Sidsolegend/lyra-imu-gesture/case/renders/functional.png

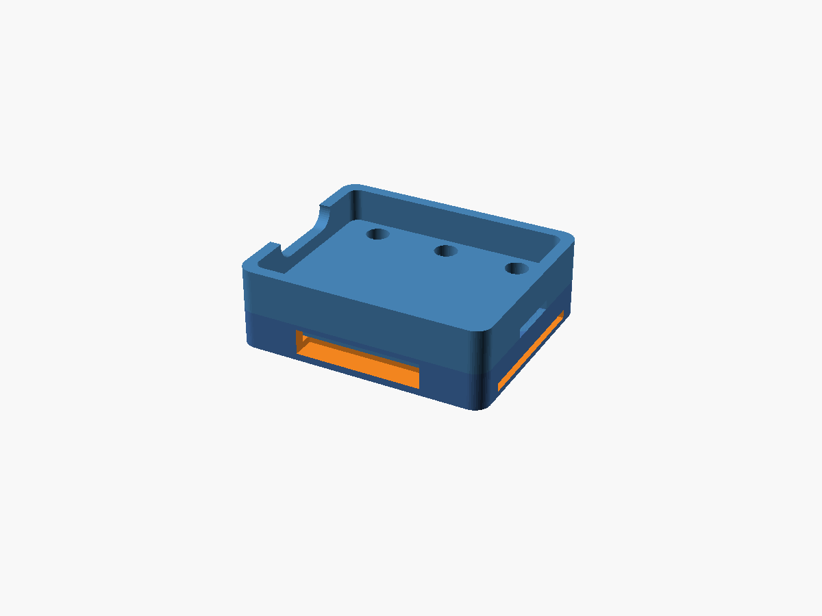
case/renders/functional.png
