Sidsolegend/lyra-imu-gesture/case/renders_v2/v2_batt_on.png

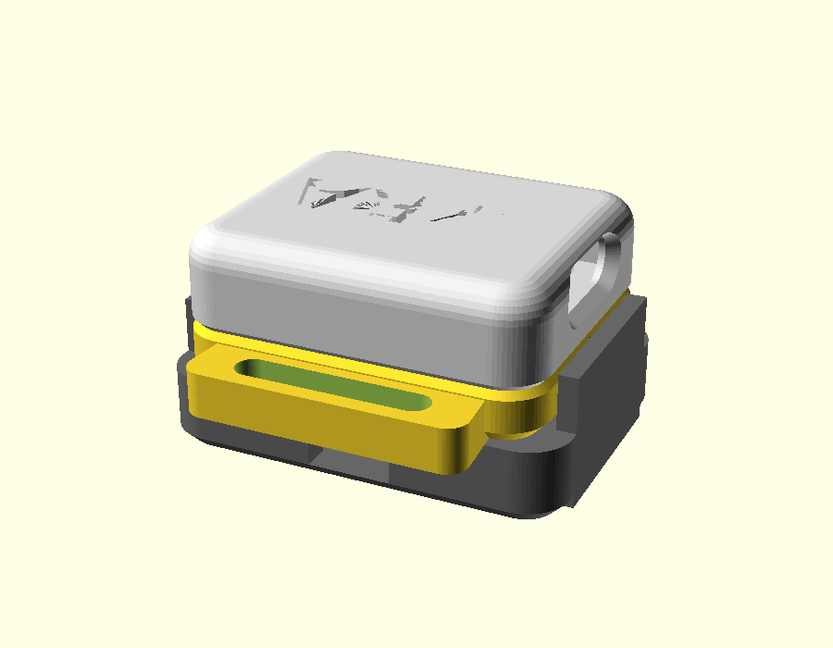
case/renders_v2/v2_batt_on.png
