Sidsolegend/lyra-imu-gesture/case/renders_v2/v2_plate.png

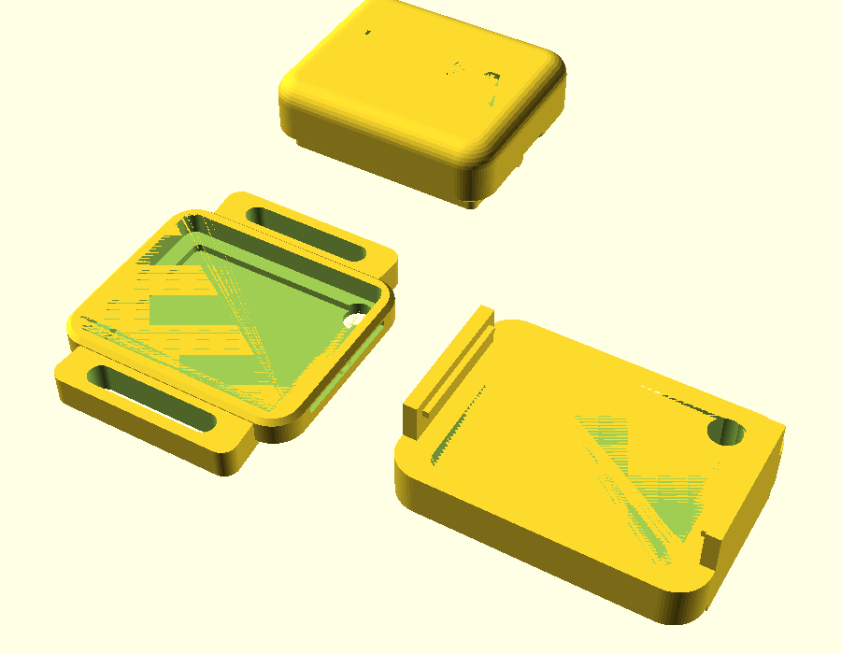
case/renders_v2/v2_plate.png
