Sidsolegend/lyra-imu-gesture/figures/mechanism_critical_gain.png

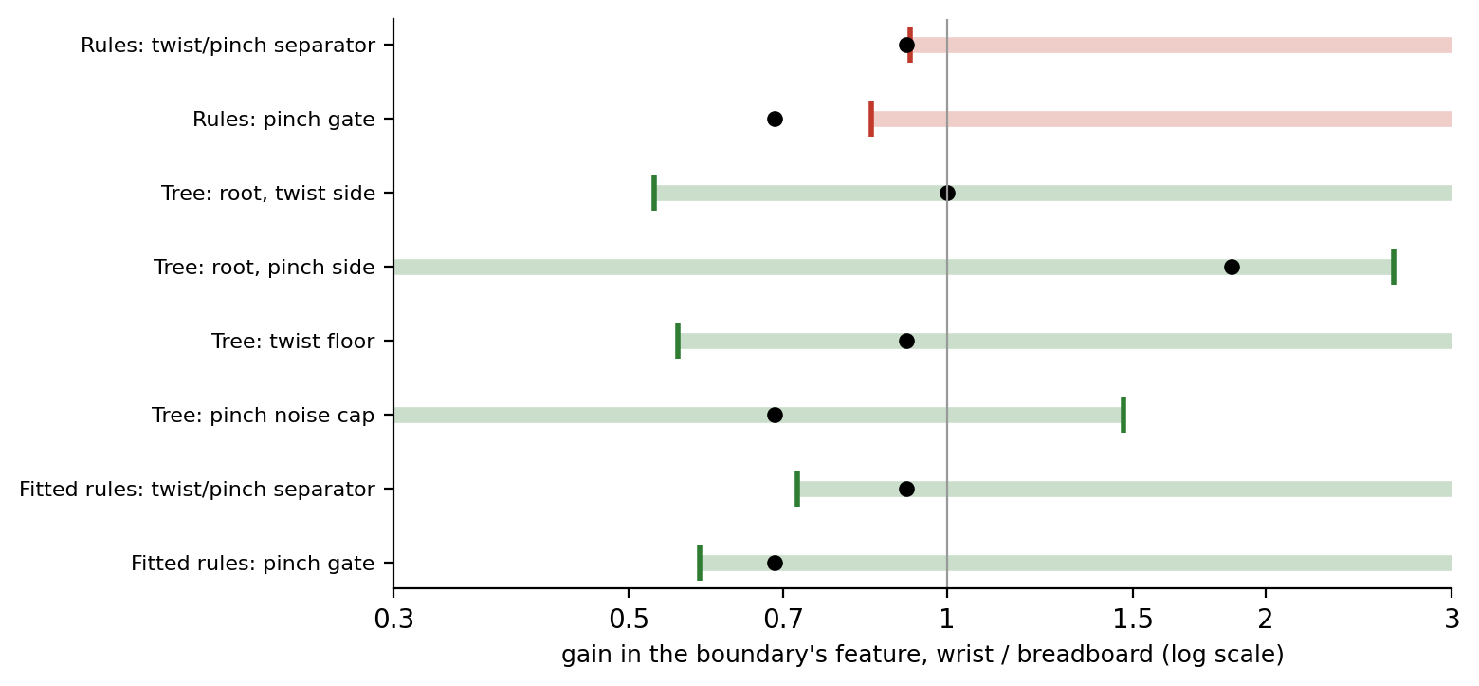
figures/mechanism_critical_gain.png
