Sidsolegend/lyra-imu-gesture/figures/mechanism_gain_sweep.png

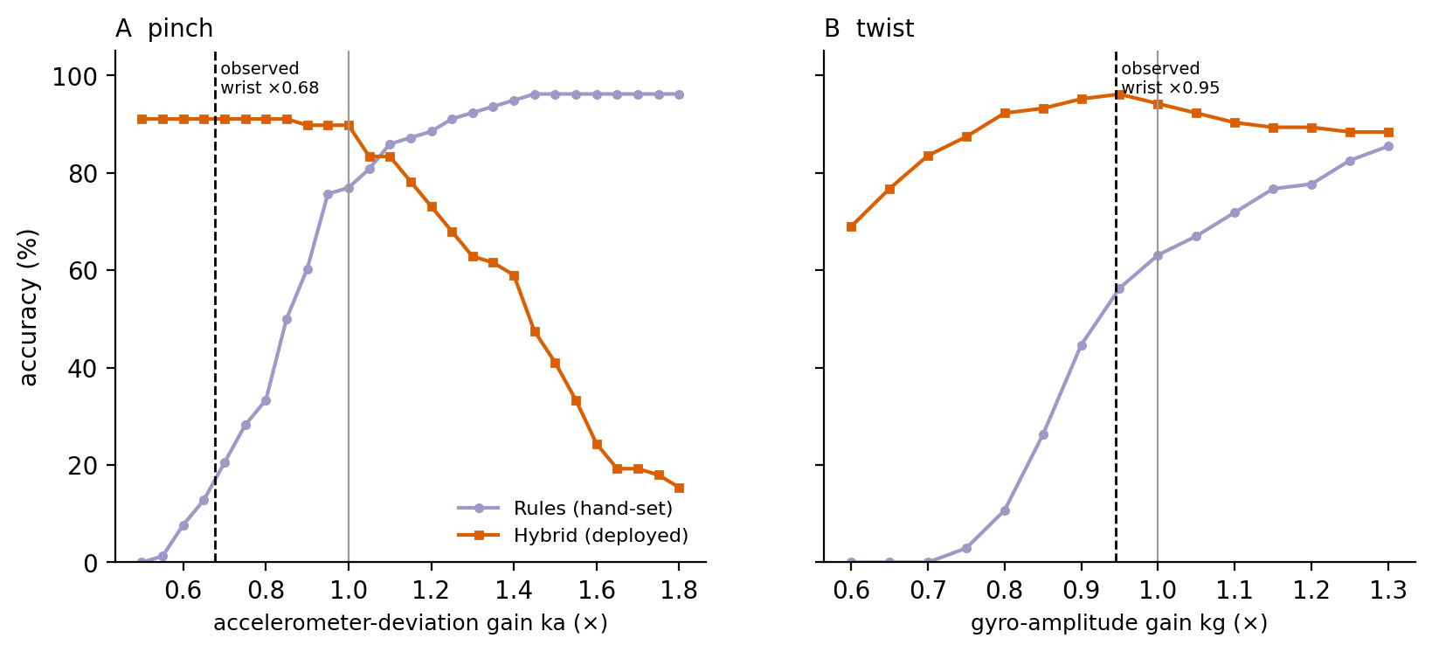
figures/mechanism_gain_sweep.png
