Sidsolegend/lyra-imu-gesture/case/stl/lyra_plate.stl

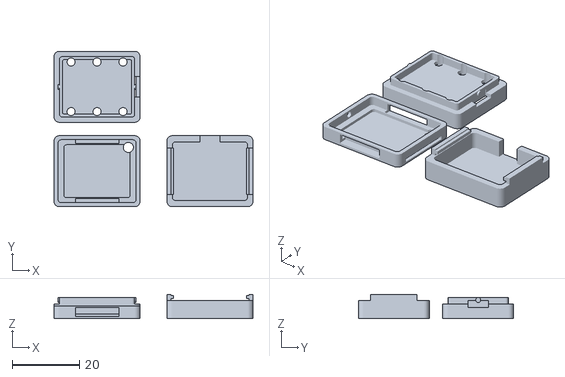
[picture p15: CAD file, 2026-10-30]
case/stl/lyra_plate.stl
59.4 x 46.4 x 7.30
