Sidsolegend/lyra-imu-gesture/case/stl_v2/lyra_v2_base.stl

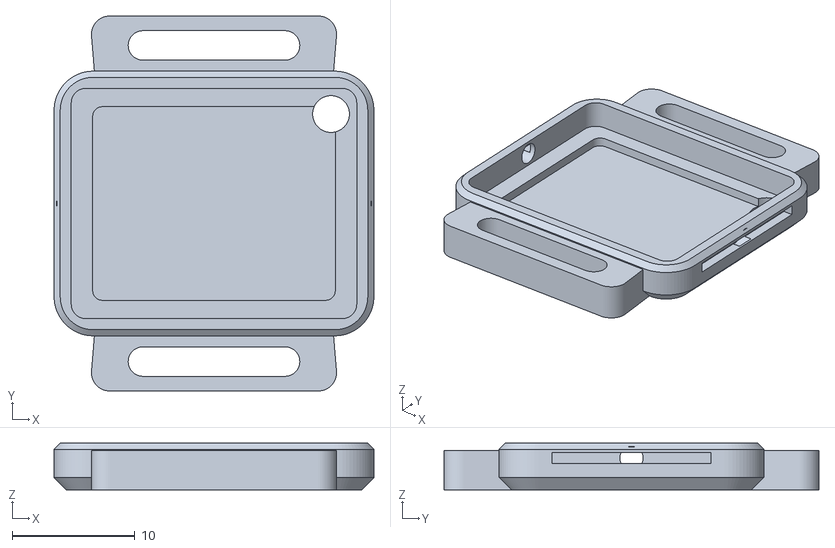
[picture p16: CAD file, 2026-10-30]
case/stl_v2/lyra_v2_base.stl
26.1 x 30.6 x 3.81
