Sidsolegend/lyra-imu-gesture/case/stl/lyra_pro_plate.stl

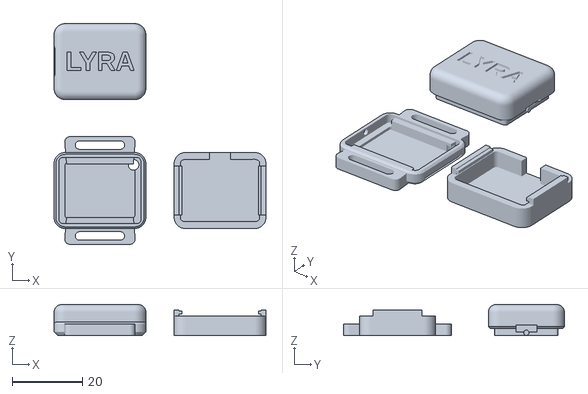
[picture p17: CAD file, 2026-10-30]
case/stl/lyra_pro_plate.stl
60.2 x 62.7 x 8.81
