Sidsolegend/lyra-imu-gesture/case/stl_v2/lyra_v2_plate.stl

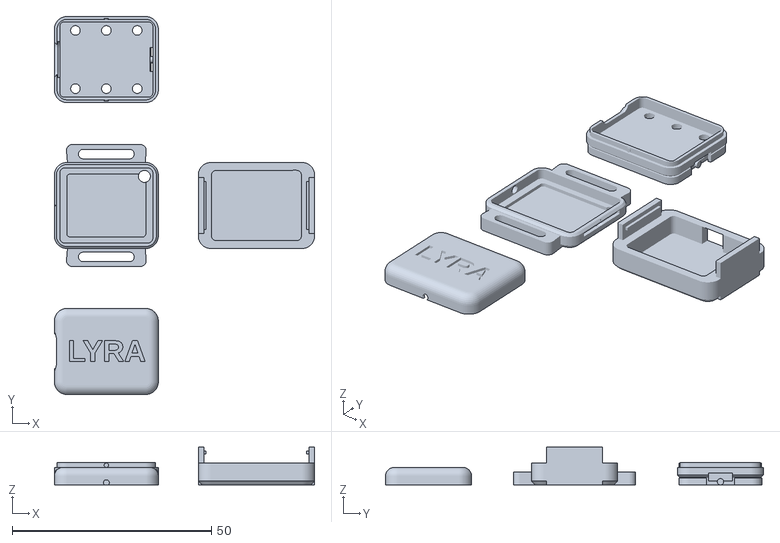
[picture p18: CAD file, 2026-10-30]
case/stl_v2/lyra_v2_plate.stl
65.3 x 94.8 x 9.50
