Sidsolegend/lyra-imu-gesture/case/stl/lyra_top.stl

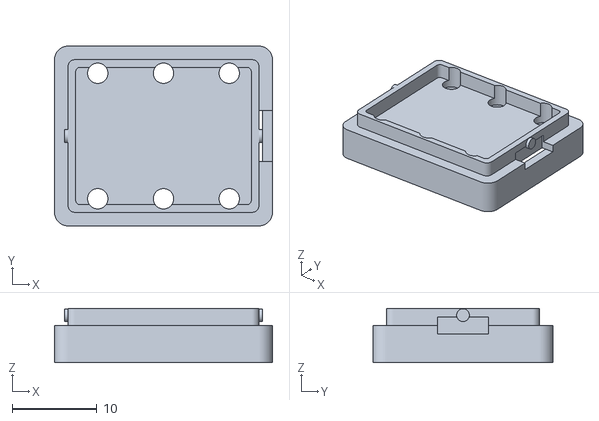
[picture p19: CAD file, 2026-10-30]
case/stl/lyra_top.stl
25.7 x 21.2 x 6.40
