Sidsolegend/lyra-imu-gesture/case/stl_v2/lyra_v2_top.stl

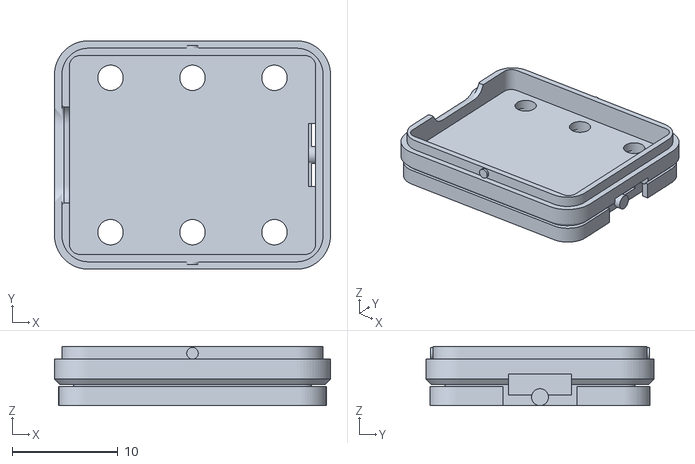
[picture p20: CAD file, 2026-10-30]
case/stl_v2/lyra_v2_top.stl
26.1 x 21.6 x 5.60
