Sidsolegend/lyra-imu-gesture/case/stl/lyra_pro_battery.stl

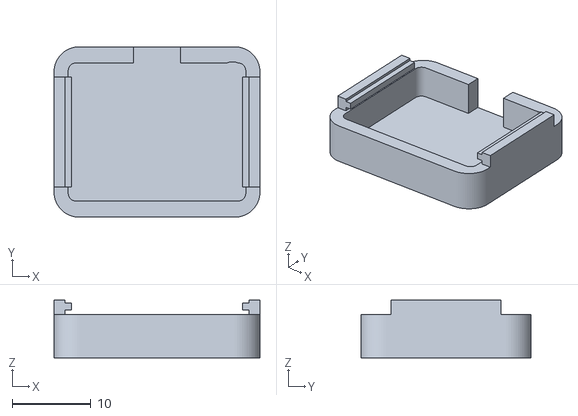
[picture p21: CAD file, 2026-10-30]
case/stl/lyra_pro_battery.stl
26.1 x 21.6 x 7.30
