Sidsolegend/lyra-imu-gesture/case/stl_v2/lyra_v2_battery.stl

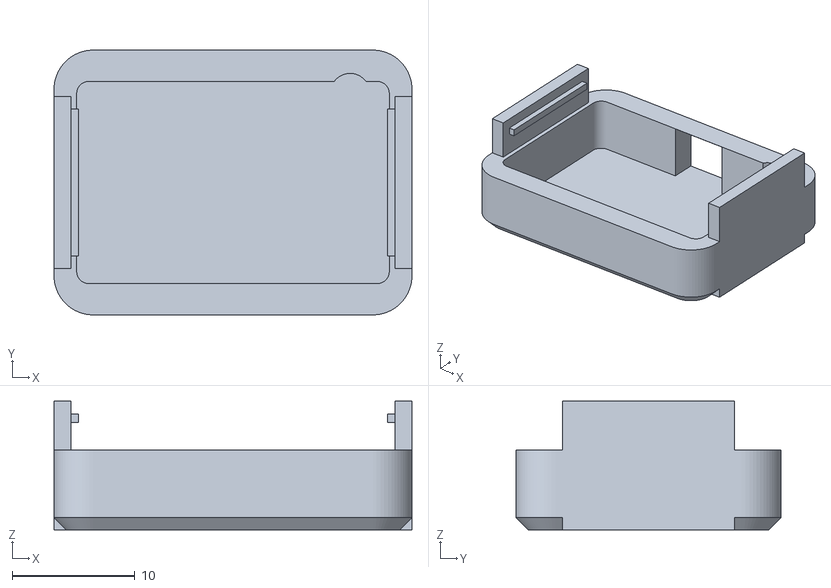
[picture p22: CAD file, 2026-10-30]
case/stl_v2/lyra_v2_battery.stl
29.2 x 21.6 x 10.5
