Sidsolegend/lyra-imu-gesture/case/stl/lyra_battery.stl

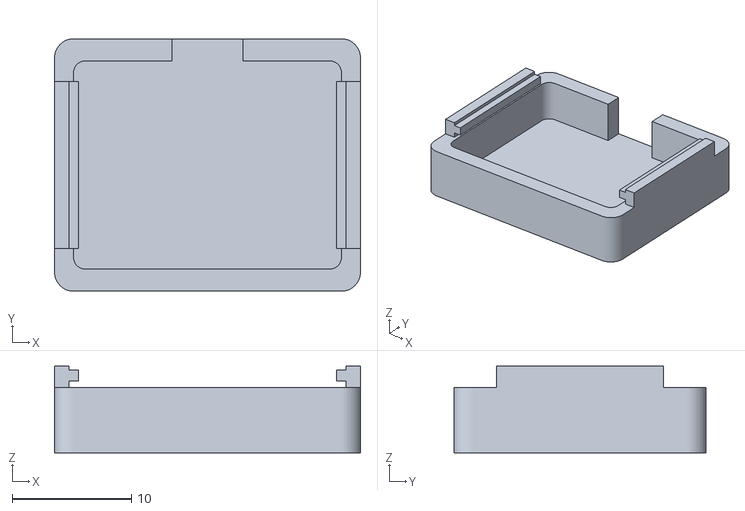
[picture p23: CAD file, 2026-10-30]
case/stl/lyra_battery.stl
25.7 x 21.2 x 7.30
