Sidsolegend/lyra-imu-gesture/case/stl_v2/lyra_v2_cap.stl

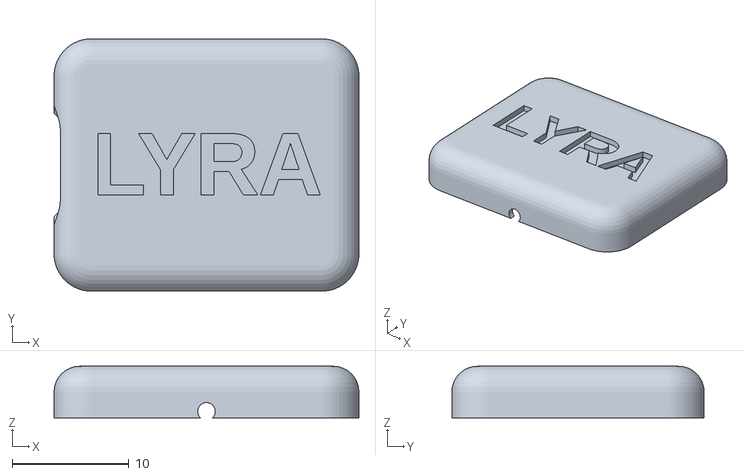
[picture p24: CAD file, 2026-10-30]
case/stl_v2/lyra_v2_cap.stl
26.1 x 21.6 x 4.41
