Sidsolegend/lyra-imu-gesture/case/stl/lyra_pro_top.stl

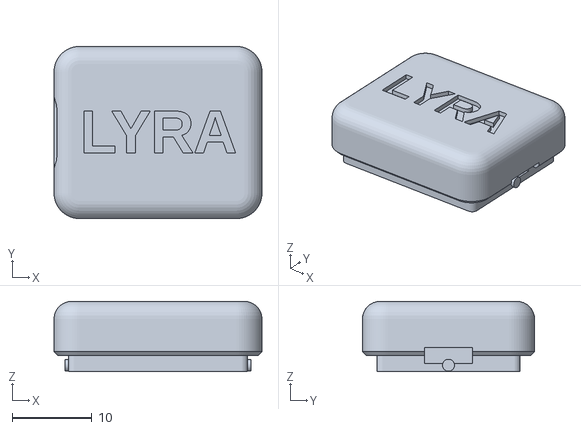
[picture p25: CAD file, 2026-10-30]
case/stl/lyra_pro_top.stl
26.1 x 21.6 x 8.81
