Sidsolegend/lyra-imu-gesture/case/stl/lyra_base.stl

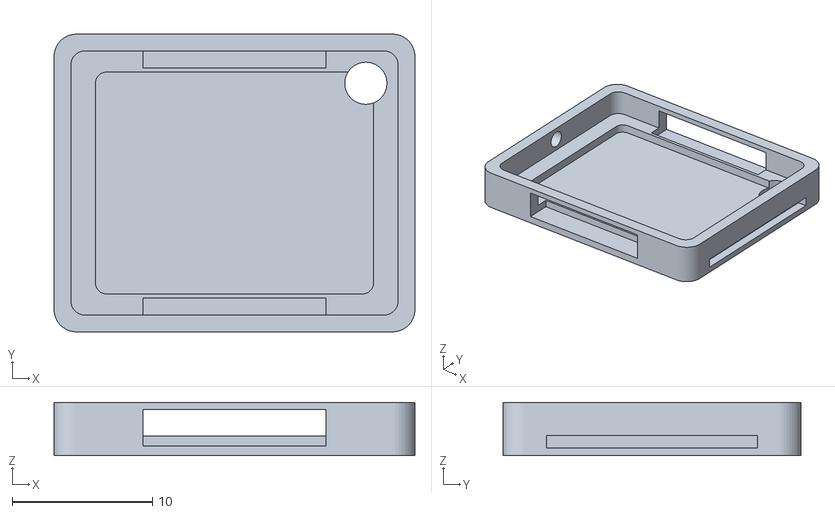
[picture p26: CAD file, 2026-10-30]
case/stl/lyra_base.stl
25.7 x 21.2 x 3.80
