Sidsolegend/lyra-imu-gesture/(list of files, cad)

Other CAD files:
case/stl/lyra_pro_base.stl
