Sidsolegend/lyra-imu-gesture/case/renders/plate_print.png

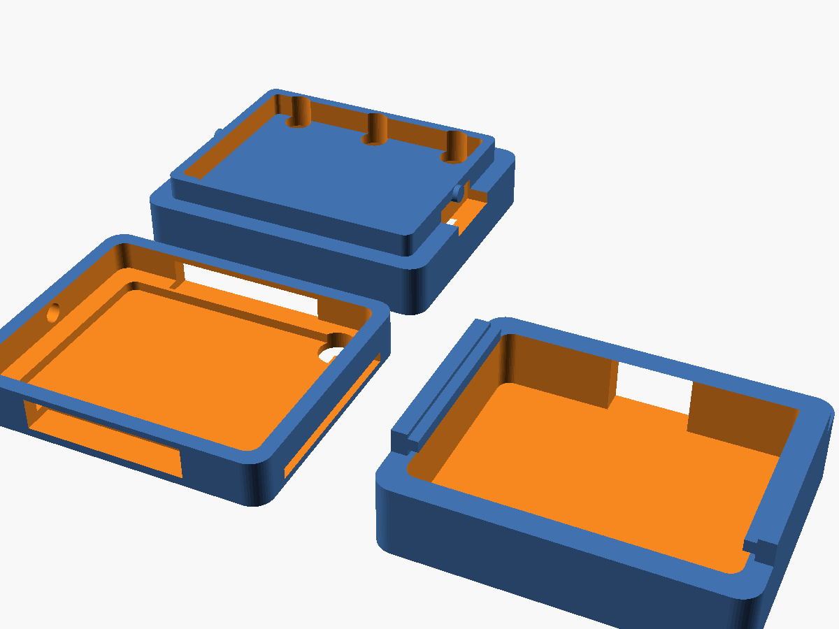
case/renders/plate_print.png
