Sidsolegend/lyra-imu-gesture/case/renders_v2/v2_assembled.png

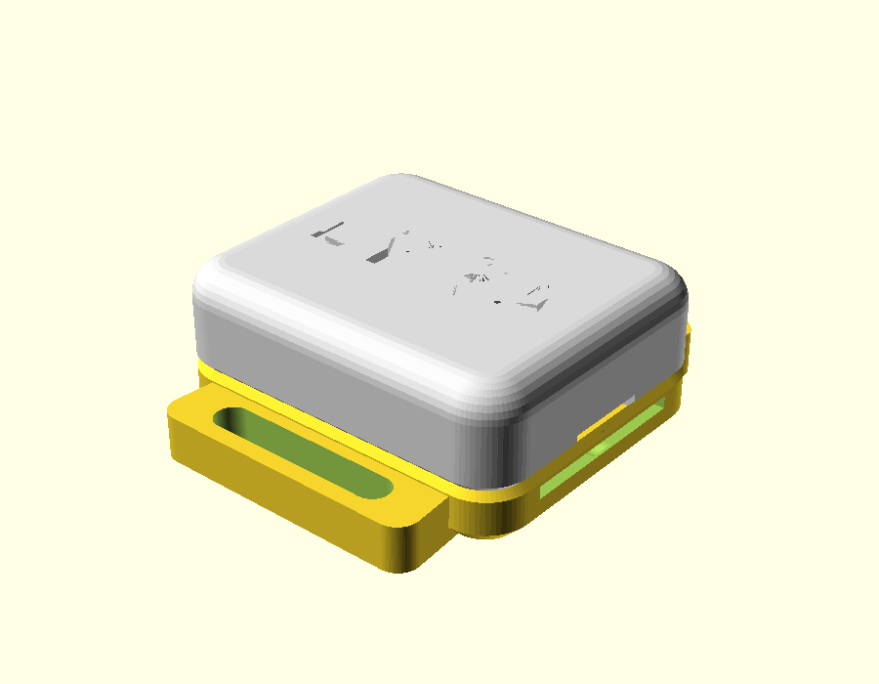
case/renders_v2/v2_assembled.png
