Sidsolegend/lyra-imu-gesture/case/renders_v2/v2_assembled_new.png

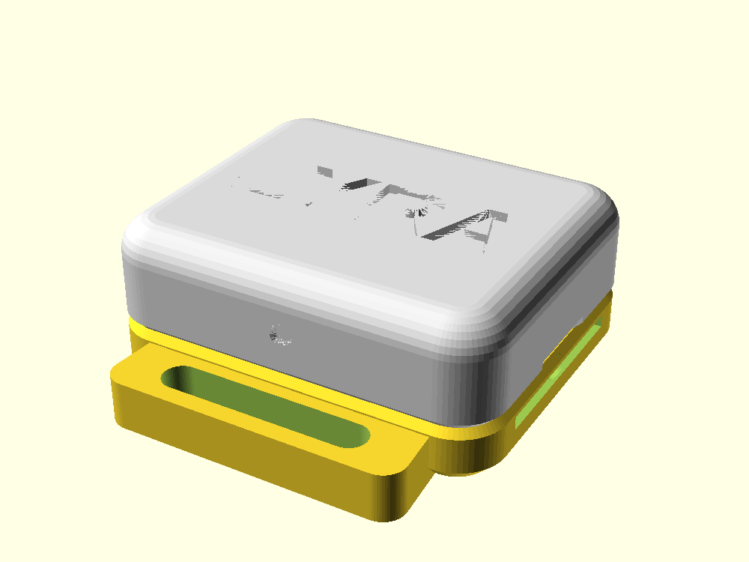
case/renders_v2/v2_assembled_new.png
