Sidsolegend/lyra-imu-gesture/case/renders_v2/v2_plate_print.png

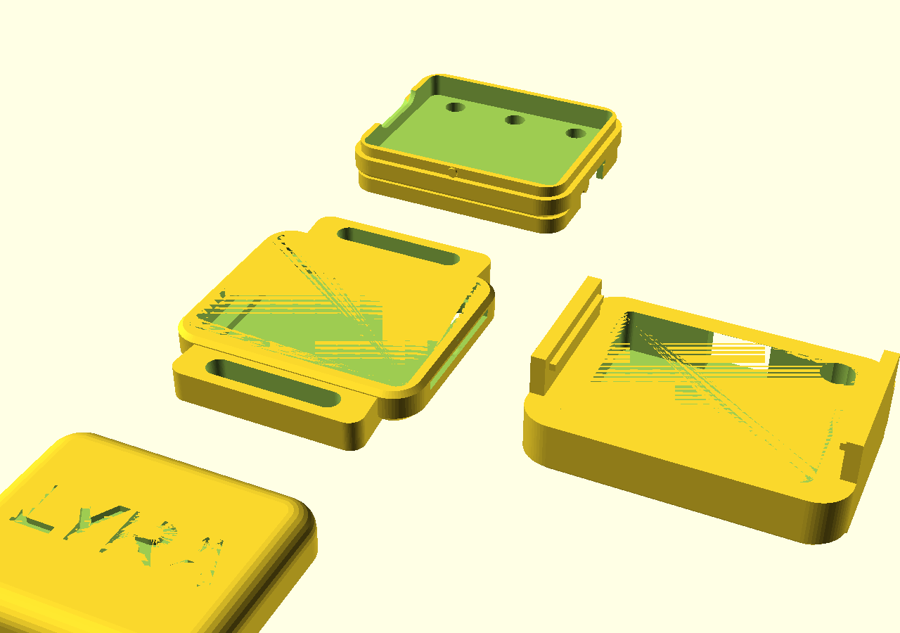
case/renders_v2/v2_plate_print.png
