Sidsolegend/lyra-imu-gesture/case/renders_v2/v2_top_print.png

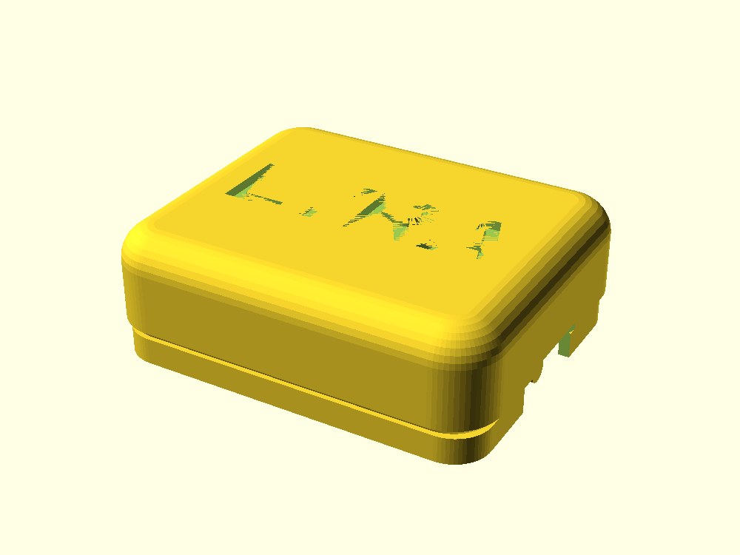
case/renders_v2/v2_top_print.png
