Sidsolegend/lyra-imu-gesture/(commit log)

2026-09-18 Add LYRA gesture-recognition data, analysis scripts, and firmware
    Companion repo for the LYRA paper: the two gesture datasets, the
    LOSO analysis harness and cross-hardware reproduction scripts, the
    deployed classifier firmware, and the manuscript.
    [lyra_multisubject.csv, real_10subj.csv]
2026-09-18 Use title case for figure axis/legend labels
    Matches the journal's figure-label formatting requirement.
2026-10-24 Add mechanism analysis: why the rules broke on the wrist mount and the hybrid did not
    research/mechanism.py runs the counterfactual experiments (component swaps in
    both directions, re-fitted rule thresholds, critical gain per boundary, a
    synthetic gain sweep, feature-subset and bootstrap trees, within-subject and
    per-participant checks) on data/ and writes three figures/mechanism_*.png.
    README lists the new command.
2026-10-25 mechanism.py: loose-mount prediction, axis mixing in the bootstrap test, repeat-participant gains
2026-10-30 Add EV3 arm code, BLE bridge, wrist case and the full firmware set; move the deployed sketch into its own folder with LED gesture feedback; add two experiments to mechanism.py
